minou65/ESP32-Powerbox/sch/Powerbox.pdf

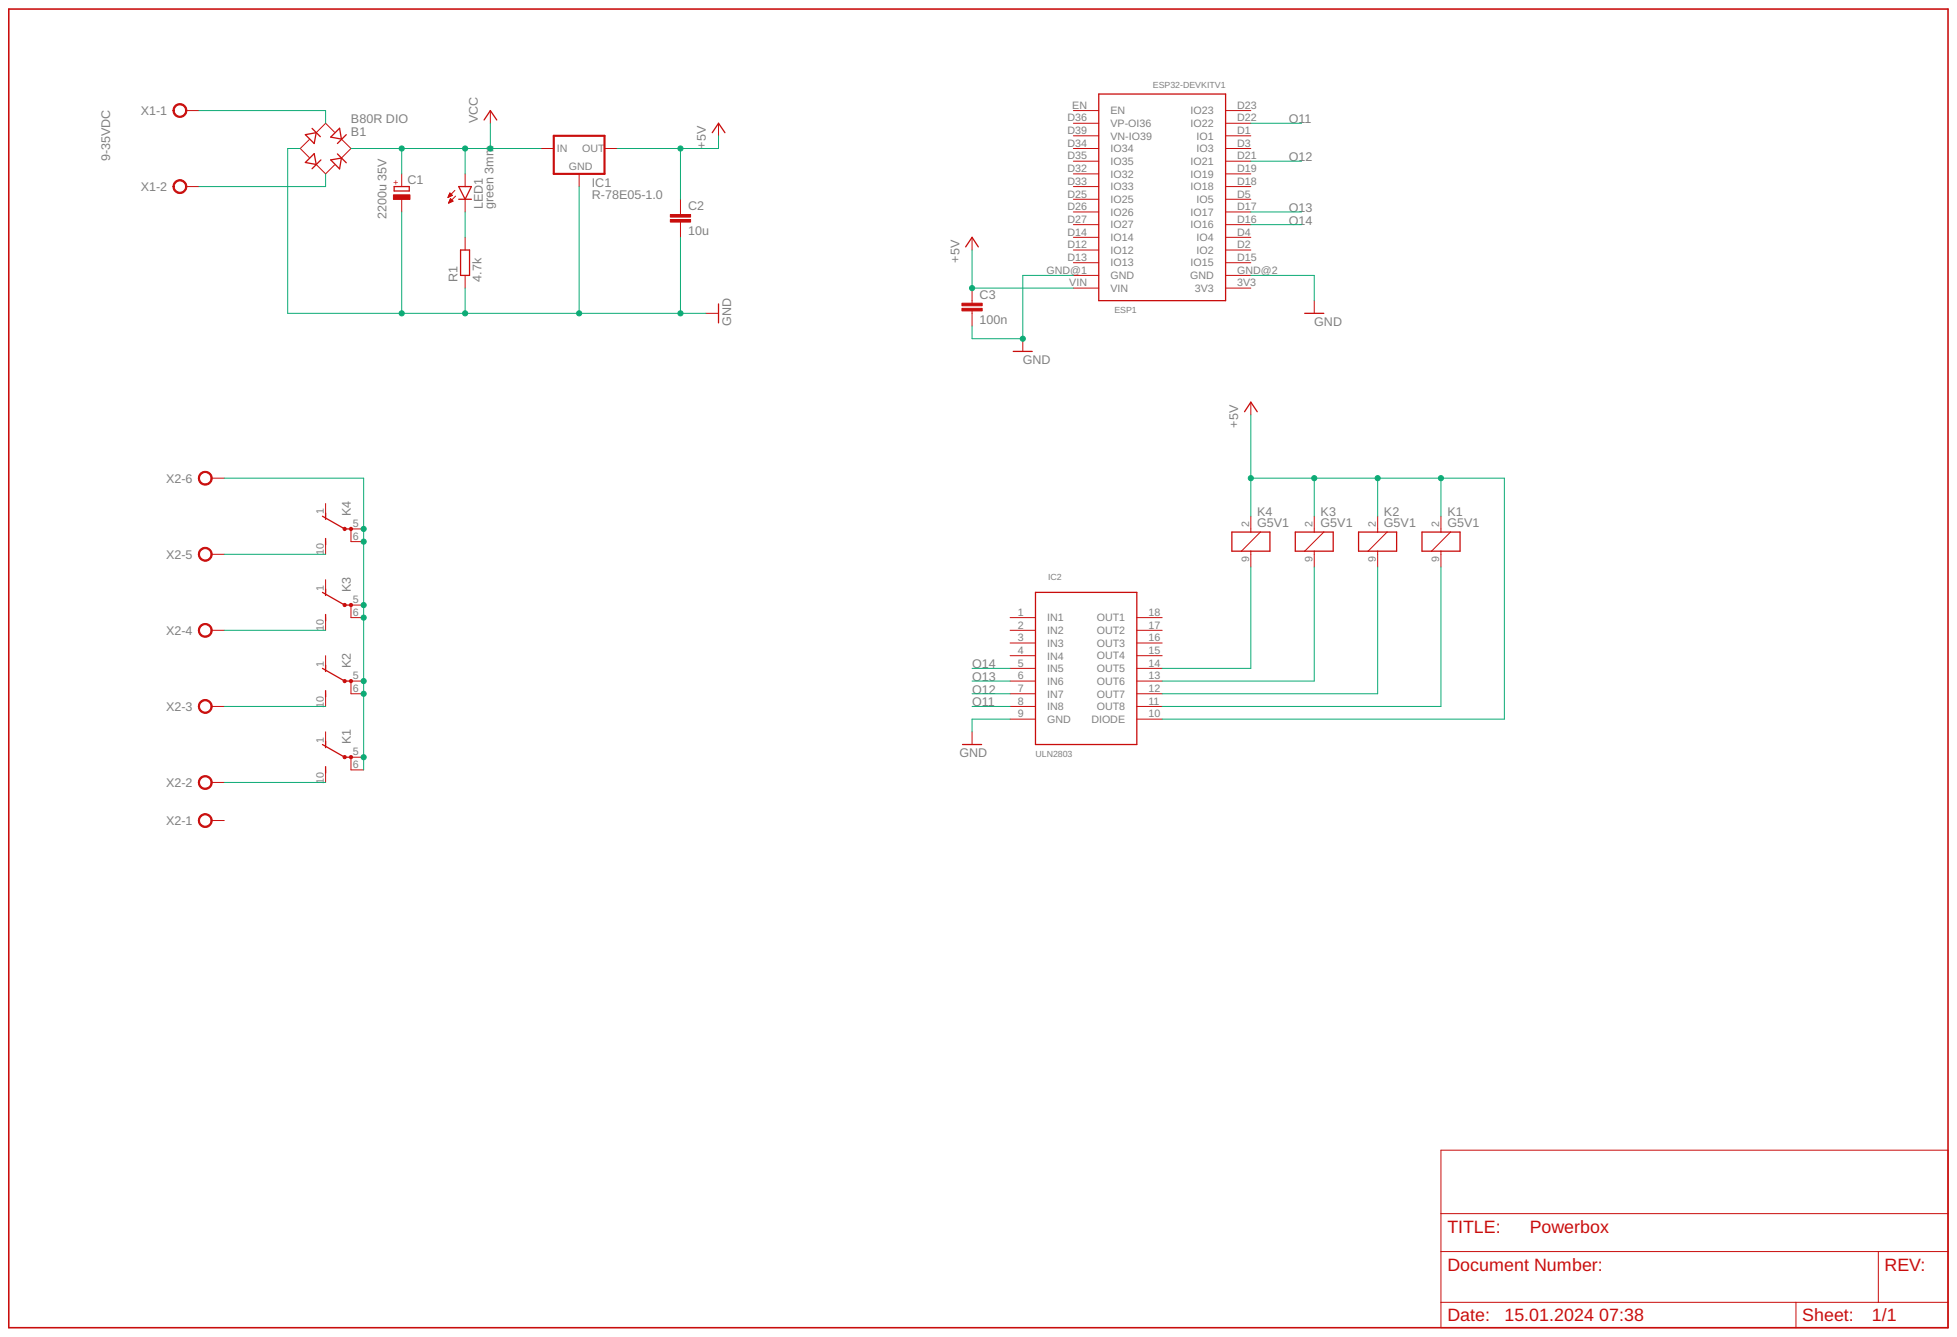
[picture p3: page 1]
