minou65/ESP32-Powerbox/sch/Powerbox.sch

## EAGLE design sch/Powerbox.sch (2024-02-17)

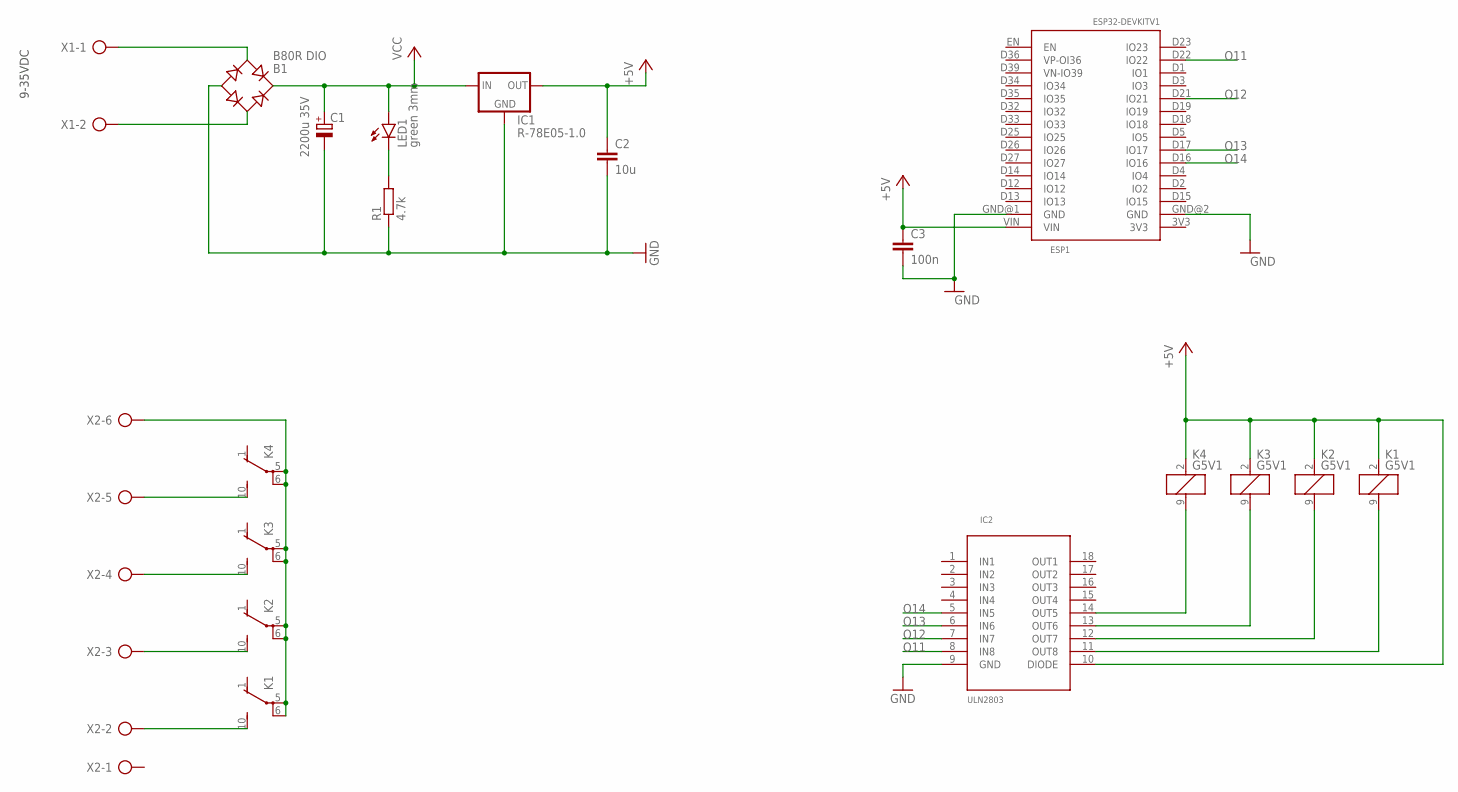
[picture p4: schematic Powerbox.sch]

Parts:
B1: B80R DIO; RB1A
C1: 2200u 35V; E5-8,5
C2: 10u; C050-024X044
C3: 100n; C050-024X044
ESP1: ESP32DEVKITV1; ESP32-DEVKITV1
IC1: R-78E05-1.0; R-78E-XX1.0
IC2: ULN2803; DIL18
K1, K2, K3, K4: G5V1
LED1: green 3mm; LED3MM
R1: 4.7k; 0207/10
X1: AK500/2
X2: AK500/6

Connections:
+5V: C2.1, C3.1, ESP1.VIN, IC1.OUT, IC2.10 (DIODE), K1.2 (1), K2.2 (1), K3.2 (1), K4.2 (1)
GND: B1.-, C1.-, C2.2, C3.2, ESP1.GND@1 (GND), ESP1.GND@2 (GND), IC1.GND, IC2.9 (GND), R1.1
unnamed: IC2.11 (OUT8), K1.9 (2)
unnamed: IC2.12 (OUT7), K2.9 (2)
unnamed: LED1.K (C), R1.2
unnamed: IC2.13 (OUT6), K3.9 (2)
unnamed: B1.AC1, X1.1
unnamed: B1.AC2, X1.2
unnamed: IC2.14 (OUT5), K4.9 (2)
unnamed: K1.5, K1.6, K2.5, K2.6, K3.5, K3.6, K4.5, K4.6, X2.6
unnamed: K4.10 (S), X2.5
unnamed: K3.10 (S), X2.4
unnamed: K2.10 (S), X2.3
unnamed: K1.10 (S), X2.2
O11: ESP1.D22 (IO22), IC2.8 (IN8)
O12: ESP1.D21 (IO21), IC2.7 (IN7)
O13: ESP1.D17 (IO17), IC2.6 (IN6)
O14: ESP1.D16 (IO16), IC2.5 (IN5)
VCC: B1.+, C1.+, IC1.IN, LED1.A

Notes on the sheet:
9-35VDC
