minou65/ESP32-Powerbox/src/Powerbox.ino

/*
 Name:		Powerbox.ino
 Created:	17.04.2023 07:05:09
 Author:	andy

 use WEMOS D1 MINI ESP32

*/

#define IOTWEBCONF_DEBUG_DISABLED

#include "ntp.h"
#include <IotWebConf.h>
#include "soc/soc.h"
#include "soc/rtc_cntl_reg.h"

#include "common.h"

#include "inverterhandling.h"
#include "webhandling.h"
#include "version.h"
#include "neotimer.h"

char Version[] = VERSION_STR; // Manufacturer's Software version code

NTPClient ntpClient;
String gNTPServer = "ntp.metas.ch"; // "pool.ntp.org";
String gTimeZone = "CET-1CEST,M3.5.0,M10.5.0/3";
bool gUseNTPServer = true;

const float PV_POWER_RESERVE_ON = 200.0f;   // Einschalt-Reserve
const float PV_POWER_RESERVE_OFF = 400.0f;  // Ausschalt-Reserve (größer!)
Neotimer printTimer(60000); // 60 Sekunden
Inverter inverter(wifiClient);

void setup() {
	WRITE_PERI_REG(RTC_CNTL_BROWN_OUT_REG, 0); //disable   detector
	Serial.begin(115200);
	while (!Serial) {
		delay(1);
	}
	Serial.println("PV Powerbox v" + String(Version) + " started");

	wifiInit();
    inverter.begin(inverterConfig.getIPAddress(), inverterConfig.getPort(), inverterConfig.getInterval());

	if (ntpConfig.useNtpServer()) {
		ntpClient.begin(ntpConfig.ntpServer(), ntpConfig.timeZone(), 0);
	}
	else {
		Serial.println(F("NTP not used"));
	}

	printTimer.start();

    for (size_t i_ = 0; i_ < MAX_DEVICES; ++i_) {
        device[i_].begin();
    }
}

void loop() {
    wifiLoop();
    if (iotWebConf.getState() == iotwebconf::OnLine) {

        inverter.process();

        PowerData powerData_ = inverter.getPowerData();
        MeterData meterData_ = inverter.getMeterData();

        float inverterActivePower_ = powerData_.activePower * 1000; // kW to W
        float gridPower_ = meterData_.activePower; // W

        float totalEnabledPower_ = 0;
        for (size_t i_ = 0; i_ < MAX_DEVICES; ++i_) {
            float power_ = device[i_].getPower();
            float partialPower_ = power_ * device[i_].getPartialLoadThreshold();
            if (device[i_].isEnabled() && device[i_].isActive()) {
                totalEnabledPower_ += power_;
            }
        }

        // Calculate available PV power
        // Note: In the inverter, gridPower_ > 0 means feed-in, gridPower_ < 0 means grid consumption!
        float availablePVPower_;
        if (gridPower_ > 0) {
            availablePVPower_ = gridPower_ - PV_POWER_RESERVE_ON + totalEnabledPower_;
            if (availablePVPower_ < 0) availablePVPower_ = 0;
            if (availablePVPower_ > inverterActivePower_) availablePVPower_ = inverterActivePower_;
        }
        else {
            // Power is being drawn from the grid or balanced: no PV surplus available
            availablePVPower_ = 0;
        }

        for (size_t i_ = 0; i_ < MAX_DEVICES; ++i_) {
            device[i_].setEnabled(false);
        }

        float remainingPVPower_ = availablePVPower_;
        float totalConsumerLoad_ = 0;
        for (size_t i_ = 0; i_ < MAX_DEVICES; ++i_) {
            float power_ = device[i_].getPower();
            float partialPower_ = power_ * device[i_].getPartialLoadThreshold();
            if (device[i_].isActive() && (
                power_ <= remainingPVPower_ ||
                (device[i_].isPartialLoadAllowed() && partialPower_ <= remainingPVPower_)
                )) {
                device[i_].setEnabled(true);
                remainingPVPower_ -= power_;
                totalConsumerLoad_ += power_;
            }
        }

        for (size_t i_ = 0; i_ < MAX_DEVICES; ++i_) {
            device[i_].process();
        }

        if (ntpClient.isInitialized()) {
            ntpClient.process();
        }

        if (printTimer.repeat()) {
            SERIAL_WEB_SERIALF("Inverter active power:%.2f W\n", inverterActivePower_);
            SERIAL_WEB_SERIALF("Grid power:%.2f W\n", gridPower_);
            SERIAL_WEB_SERIALF("Total consumer load:%.2f W\n", totalConsumerLoad_);
            SERIAL_WEB_SERIALF("Available PV power:%.2f W\n", availablePVPower_);
            SERIAL_WEB_SERIALLN("----");
        }
    }
    else {
        for (size_t i_ = 0; i_ < MAX_DEVICES; ++i_) {
            if (device[i_].isEnabled() && device[i_].isActive()) {
                device[i_].setEnabled(false);
                SERIAL_WEB_SERIALF("Disabled consumer: %s\n", device[i_].getDesignation().c_str());
            }
        }
    }

    if (gParamsChanged) {
        for (size_t i_ = 0; i_ < MAX_DEVICES; ++i_) {
            device[i_].end();
            device[i_].begin();

            if (!device[i_].isActive()) {
                device[i_].setEnabled(false);
                device[i_].applyDefaultValue();
            }
        }

        inverter.end();
        inverter.begin(inverterConfig.getIPAddress(), inverterConfig.getPort(), inverterConfig.getInterval());

        if (ntpConfig.useNtpServer()) {
            ntpClient.begin(ntpConfig.ntpServer(), ntpConfig.timeZone(), 0);
        }
    }

    if (ShouldReboot) {
        SERIAL_WEB_SERIALLN("Rebooting...");
        for (size_t i_ = 0; i_ < MAX_DEVICES; ++i_) {
            device[i_].end();
        }
        inverter.end();
        delay(1000);
        ESP.restart();
    }

    gParamsChanged = false;
}
