minou65/ESP32-Powerbox/src/favicon.h

// favicon.h

#ifndef _FAVICON_h
#define _FAVICON_h

#if defined(ARDUINO) && ARDUINO >= 100
	#include "arduino.h"
#else
	#include "WProgram.h"
#endif

const uint8_t favicon_ico[] PROGMEM = { // icons8-solarpaneel-16.png
0x89, 0x50, 0x4E, 0x47, 0x0D, 0x0A, 0x1A, 0x0A, 0x00, 0x00, 0x00, 0x0D, 0x49, 0x48, 0x44, 0x52,
0x00, 0x00, 0x00, 0x10, 0x00, 0x00, 0x00, 0x10, 0x08, 0x06, 0x00, 0x00, 0x00, 0x1F, 0xF3, 0xFF,
0x61, 0x00, 0x00, 0x00, 0x09, 0x70, 0x48, 0x59, 0x73, 0x00, 0x00, 0x0B, 0x13, 0x00, 0x00, 0x0B,
0x13, 0x01, 0x00, 0x9A, 0x9C, 0x18, 0x00, 0x00, 0x01, 0xD1, 0x49, 0x44, 0x41, 0x54, 0x78, 0x9C,
0x63, 0x60, 0x40, 0x02, 0x4A, 0xE2, 0x82, 0x3A, 0x20, 0xCC, 0x40, 0x0E, 0xD0, 0x51, 0x10, 0xDC,
0x53, 0x1B, 0x63, 0xF0, 0xB8, 0x3E, 0xC6, 0xE0, 0x91, 0xB6, 0x82, 0xC0, 0x1E, 0x92, 0x34, 0x2B,
0x8A, 0xF1, 0x54, 0xB7, 0x27, 0x1B, 0xBF, 0x4F, 0x08, 0x52, 0xFB, 0x9F, 0x10, 0xA2, 0xFC, 0xBF,
0x23, 0xD9, 0xE4, 0x1D, 0x48, 0x8C, 0x68, 0x03, 0x94, 0x24, 0x79, 0xF3, 0x67, 0x16, 0x58, 0xFD,
0xEB, 0x6B, 0xB3, 0xFC, 0x3F, 0xA1, 0xD1, 0xE8, 0xFF, 0xAC, 0x42, 0xAB, 0x7F, 0x0A, 0x92, 0xBC,
0x79, 0x44, 0x1B, 0x20, 0xC2, 0xCF, 0x65, 0x18, 0x68, 0x2D, 0x7F, 0x75, 0x4E, 0x99, 0xCD, 0xFF,
0x45, 0x35, 0xB6, 0xFF, 0x83, 0x6C, 0xE4, 0xAF, 0x80, 0xC4, 0x48, 0xF2, 0x86, 0x96, 0x3C, 0x7F,
0x82, 0xA9, 0xBA, 0xE8, 0x56, 0x53, 0x75, 0xE1, 0xAD, 0x20, 0x36, 0x16, 0x25, 0x62, 0x2E, 0x2E,
0xEE, 0x8F, 0x9C, 0x5D, 0x5D, 0x7B, 0x34, 0x79, 0xF8, 0x9E, 0xE8, 0xF3, 0x09, 0x1E, 0x24, 0xDA,
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
0x82, 0xD8, 0xA6, 0xC3, 0x20, 0x41, 0x9E, 0x06, 0xBD, 0x64, 0x69, 0x10, 0x53, 0x9D, 0xB9, 0x34,
0xB8, 0x61, 0x5E, 0xB0, 0x3C, 0x0D, 0xFE, 0xEB, 0xC8, 0x69, 0x50, 0x3C, 0x08, 0xC5, 0x98, 0x3A,
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
};

#endif
