minou65/ESP32-Powerbox/src/common.h

// common.h

#ifndef _COMMON_h
#define _COMMON_h

#if defined(ARDUINO) && ARDUINO >= 100
	#include "arduino.h"
#else
	#include "WProgram.h"
#endif

#include "neotimer.h"

#define STRING_LEN 50
#define NUMBER_LEN 6

extern char Version[];

extern bool gParamsChanged;

#endif
