minou65/ESP32-Powerbox/(commit log)

2024-01-15 schema added
    [Powerbox.sch]
2024-03-04 update relay and inverter setup after params changed
2024-04-23 reboot button from portal side to config side moved
    [webhandling.cpp]
2024-04-23 fixed missing shelly updates
    [webhandling.h]
2024-04-27 added status LED's instead of text
2025-10-11 refactor: streamline WiFi connection handling and add failure callback
    [Powerbox.ino, webhandling.cpp, webhandling.h]
2025-10-11 refactor: remove ESP32Time class and improved ntp and time handling
2025-10-11 refactor: improve relay handling function signatures for clarity
2025-10-13 refactor: remove unused inverter input power variables from common.h
2025-10-13 refactor: include inverterhandling.h and update relay enable logic to use inverterPowerData
2025-10-13 refactor: clean up includes and remove unused input power variables in inverterhandling.cpp
2025-10-13 refactor: simplify ON_LEVEL definition for ESP32 by removing conditional compilation
2025-10-13 fix: prevent relay activation when power is zero
2025-10-17 refactor: replace Serial logging with ESP_LOG
    [inverterhandling.cpp]
2025-10-17 refactor: remove unused loopRelays function and clean up includes in RelayHandling
2025-10-17 refactor: introduce Consumer interface and update Relay/Shelly classes for better abstraction
2025-10-17 refactor: enhance consumer management logic in loop function for better power allocation
2025-10-24 refactor: enhance Consumer class with status management and delay handling in Relay
2025-10-24 refactor: improve relay status handling and streamline Shelly display logic
2025-10-24 refactor: optimize consumer power management and simplify enabling logic
2025-10-25 fix: default value application
    [Powerbox.ino, webhandling.cpp, webhandling.h]
2025-10-25 refactor: enhance Relay class with delay and time parameters for improved control
2025-10-25 feat: implement reboot handling with inverter shutdown in loop
    [Powerbox.ino, webhandling.cpp, webhandling.h]
2025-10-25 fix: add webserial link
    [webhandling.cpp]
2025-10-25 refactor: streamline logging of power metrics in loop function
2025-10-25 refactor: optimize Shelly enable/disable logic and improve timer handling
2025-10-26 feat: enhance consumer power management with partial load handling
2025-10-26 refactor: simplify Shelly status handling and update reset log message
    [webhandling.cpp]
2026-01-12 refactor: unify device handling by replacing Consumer with a generic device interface
2026-01-12 Refactor webhandling to support SwitchDevice class and improve HTML handling
    - Removed unused includes and organized existing ones in webhandling.cpp and webhandling.h.
    - Introduced SwitchDevice class to replace Relay and Shelly classes, consolidating device management.
    - Updated HTML generation to dynamically handle device fields and actions.
    - Replaced hardcoded relay handling with a vector of SwitchDevice instances for scalability.
    - Enhanced JavaScript for better user interaction and device management.
    - Updated configuration handling to accommodate new device structure.
    [webhandling.cpp, webhandling.h]
2026-02-09 refactor: replace vector of SwitchDevice with static array for improved performance and memory management
    [Powerbox.ino, webhandling.cpp, webhandling.h]
2026-02-19 fix: always receive meter data
    [inverterhandling.cpp]
